njh/modbus-room-sensor/modbus-room-sensor.kicad_pcb

## KiCad design modbus-room-sensor.kicad_pcb (2026-11-06)

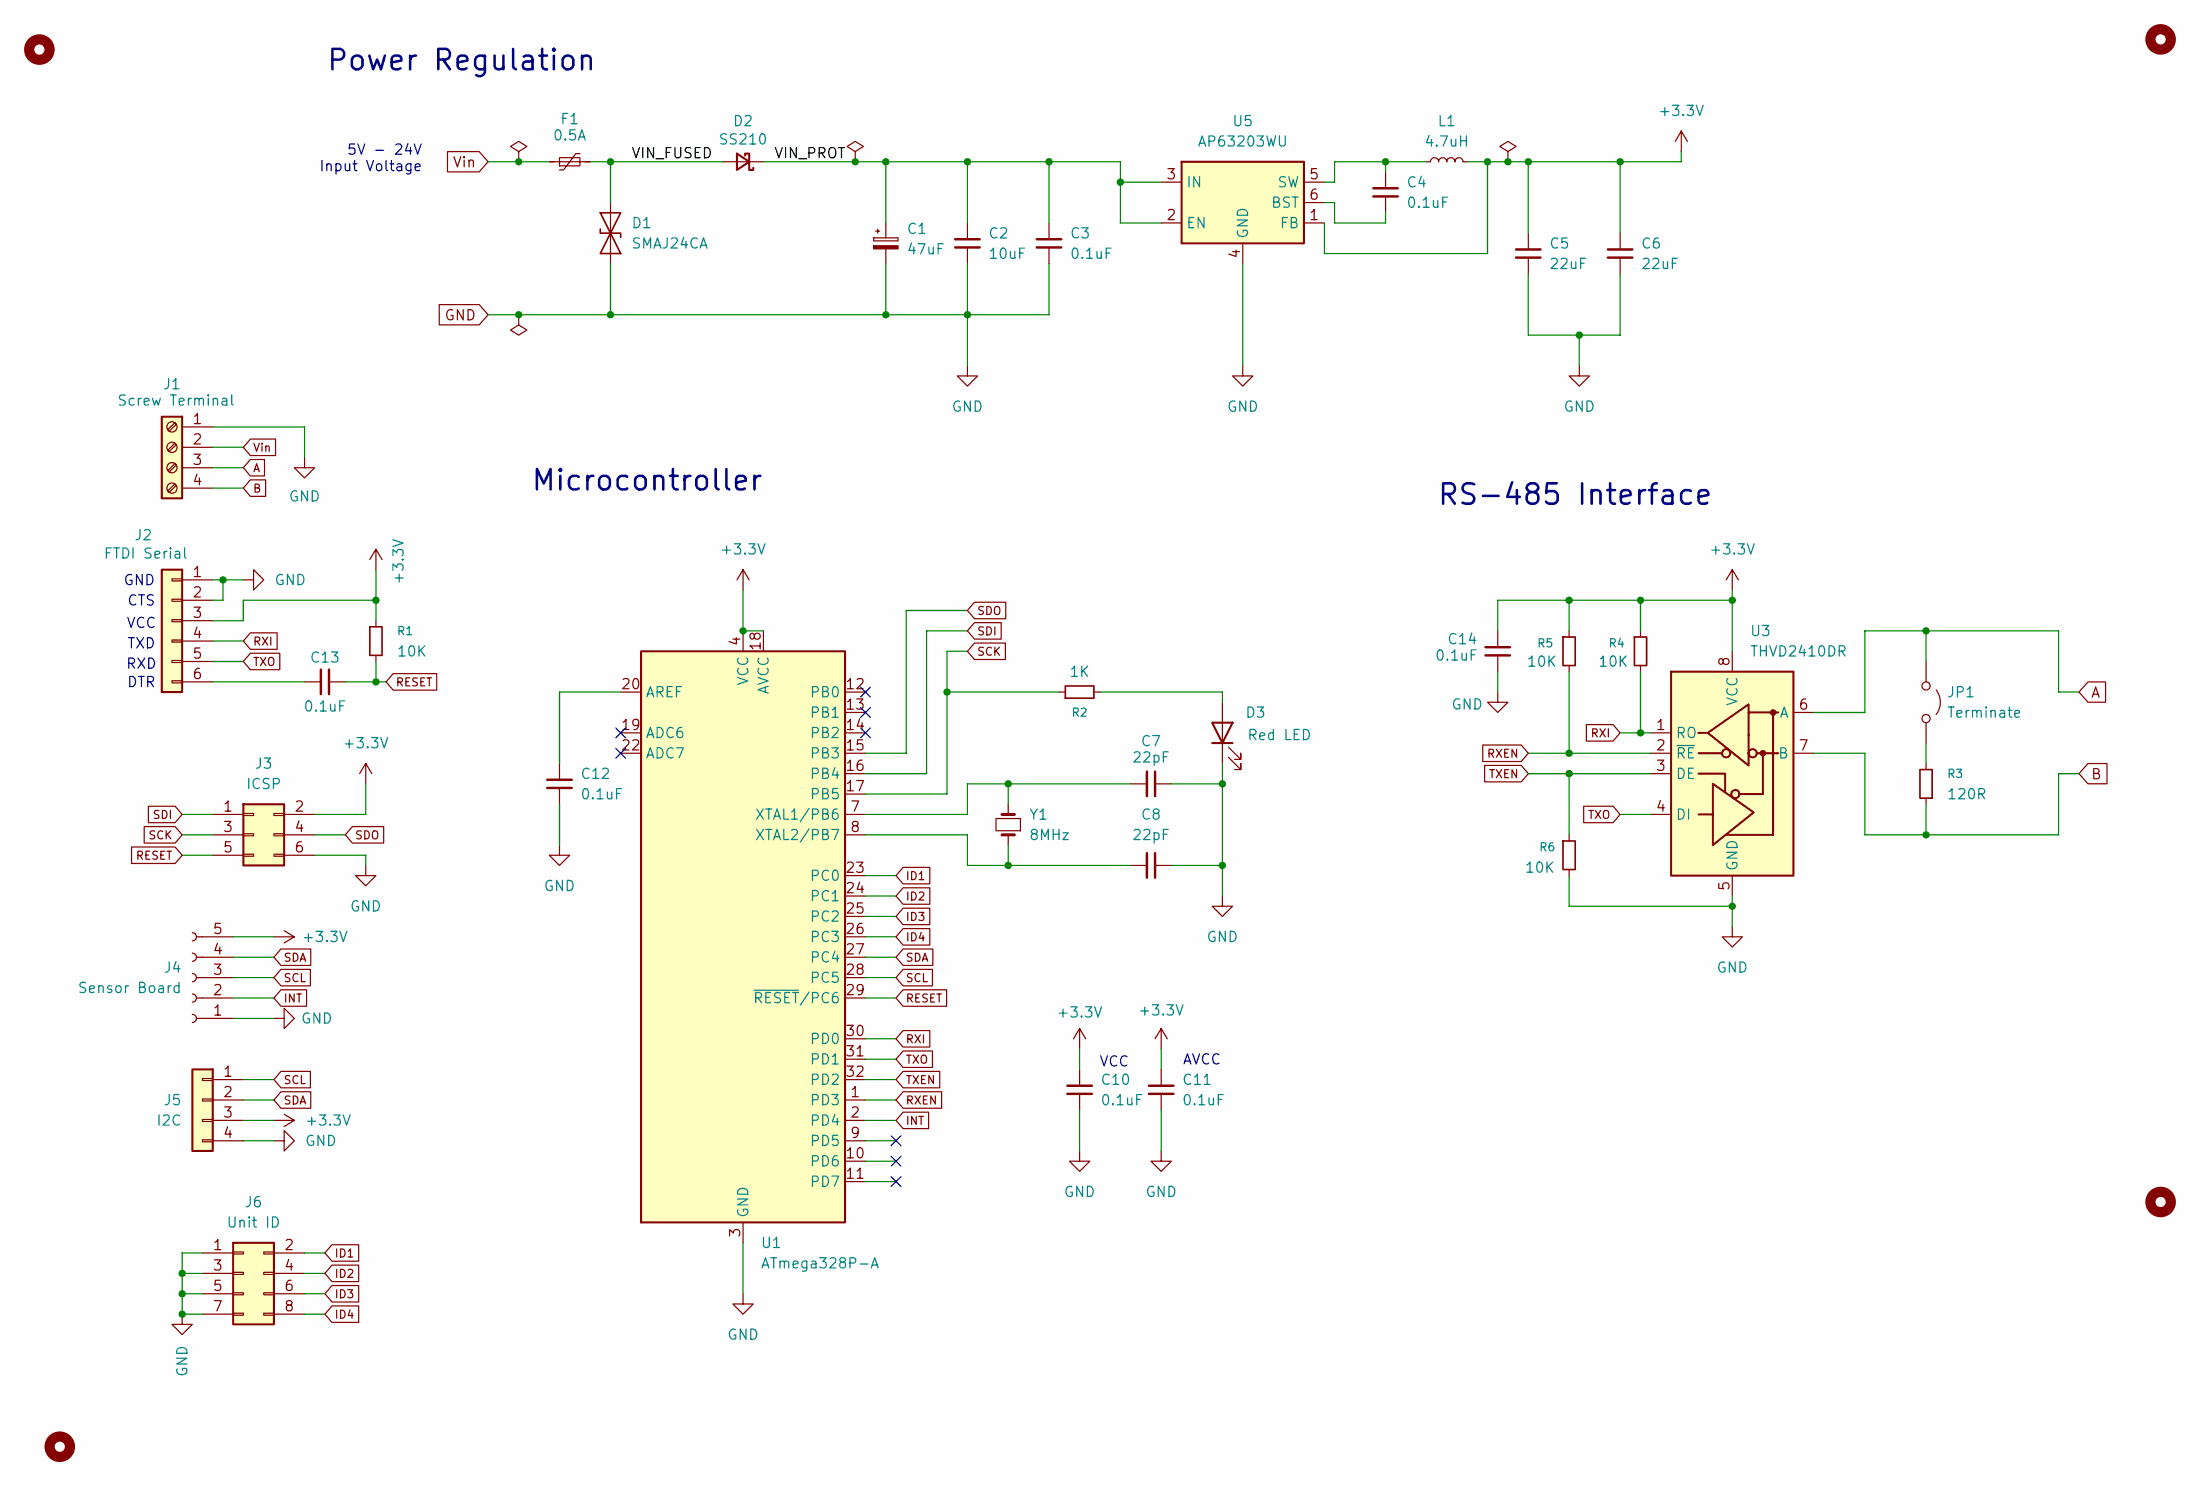
[picture p2: schematic modbus-room-sensor.kicad_sch, Modbus Room Sensor]

Parts:
C1: 47uF; CP_Radial_D6.3mm_P2.50mm
C2: 10uF; C_0805_2012Metric; LCSC C440198
C3, C4: 0.1uF; C_0603_1608Metric; LCSC C14663
C5, C6: 22uF; C_1206_3216Metric; LCSC C12891
C7, C8: 22pF; C_0603_1608Metric; LCSC C1653
C10, C11, C12, C13, C14: 0.1uF; C_0402_1005Metric; LCSC C1525
D1: SMAJ24CA; D_SMA; LCSC C19077542
D2: SS210; D_SMA; LCSC C14996
D3: Red LED; LED_0805_2012Metric; LCSC C84256
F1: 0.5A; C_Disc_D8.0mm_W5.0mm_P5.00mm
H1, H2, H3, H4: MountingHole; MountingHole_2.7mm_M2.5
J1: Screw Terminal; Kefa_HT396R-3.96-04P_1x04_P3.96mm_Horizontal
J2: FTDI Serial; PinHeader_1x06_P2.54mm_Vertical
J3: ICSP; PinHeader_2x03_P2.54mm_Vertical
J4: Sensor Board; PinSocket_1x05_P2.54mm_Horizontal
J5: I2C; JST_PH_B4B-PH-K_1x04_P2.00mm_Vertical
J6: Unit ID; PinHeader_2x04_P2.54mm_Vertical
JP1: Terminate; PinHeader_1x02_P2.54mm_Vertical
L1: 4.7uH; L_Sunlord_SWPA4030S; LCSC C57269
R1, R4, R5, R6: 10K; R_0603_1608Metric; LCSC C25804
R2: 1K; R_0603_1608Metric; LCSC C21190
R3: 120R; R_1206_3216Metric; LCSC C17909
U1: ATmega328P-A; TQFP-32_7x7mm_P0.8mm; LCSC C14877
U3: THVD2410DR; SOIC-8_3.9x4.9mm_P1.27mm; LCSC C1849398
U5: AP63203WU; TSOT-23-6; LCSC C780769
Y1: 8MHz; Crystal_SMD_5032-2Pin_5.0x3.2mm; LCSC C115962

Connections:
+3.3V: C5.1, C6.1, C10.1, C11.1, C14.1, J2.3, J3.2, J4.5, J5.3, L1.2, R1.1, R4.1, R5.1, U1.4 (VCC), U1.6 (VCC), U1.18 (AVCC), U3.8 (VCC), U5.1 (FB)
/VIN_FUSED: D1.2 (A2), D2.2 (A), F1.2
/VIN_PROT: C1.1, C2.1, C3.1, D2.1 (K), U5.2 (EN), U5.3 (IN)
A: J1.3, JP1.1 (A), U3.6 (A)
B: J1.4, R3.1, U3.7 (B)
GND: C1.2, C2.2, C3.2, C5.2, C6.2, C7.2, C8.2, C10.2, C11.2, C12.2, C14.2, D1.1 (A1), D3.1 (K), J1.1, J2.1, J2.2, J3.6, J4.1, J5.4, J6.1, J6.3, J6.5, J6.7, R6.2, U1.3 (GND), U1.5 (GND), U1.21 (GND), U3.5 (GND), U5.4 (GND)
ID1: J6.2, U1.23 (PC0)
ID2: J6.4, U1.24 (PC1)
ID3: J6.6, U1.25 (PC2)
ID4: J6.8, U1.26 (PC3)
INT: J4.2, U1.2 (PD4)
unnamed: D3.2 (A), R2.2
unnamed: C13.1, J2.6
unnamed: JP1.2 (B), R3.2
unnamed: C12.1, U1.20 (AREF)
unnamed: C7.1, U1.7 (XTAL1/PB6), Y1.2
unnamed: C8.1, U1.8 (XTAL2/PB7), Y1.1
unnamed: C4.2, U5.6 (BST)
unnamed: C4.1, L1.1, U5.5 (SW)
RESET: C13.2, J3.5, R1.2, U1.29 (~RESET/PC6)
RXEN: R5.2, U1.1 (PD3), U3.2 (~RE)
RXI: J2.4, R4.2, U1.30 (PD0), U3.1 (RO)
SCK: J3.3, R2.1, U1.17 (PB5)
SCL: J4.3, J5.1, U1.28 (PC5)
SDA: J4.4, J5.2, U1.27 (PC4)
SDI: J3.1, U1.16 (PB4)
SDO: J3.4, U1.15 (PB3)
TXEN: R6.1, U1.32 (PD2), U3.3 (DE)
TXO: J2.5, U1.31 (PD1), U3.4 (DI)
Vin: F1.1, J1.2

Notes on the sheet:
AVCC
TXD
VCC
Microcontroller
5V - 24V Input Voltage
CTS
GND
Power Regulation
DTR
RS-485 Interface
RXD

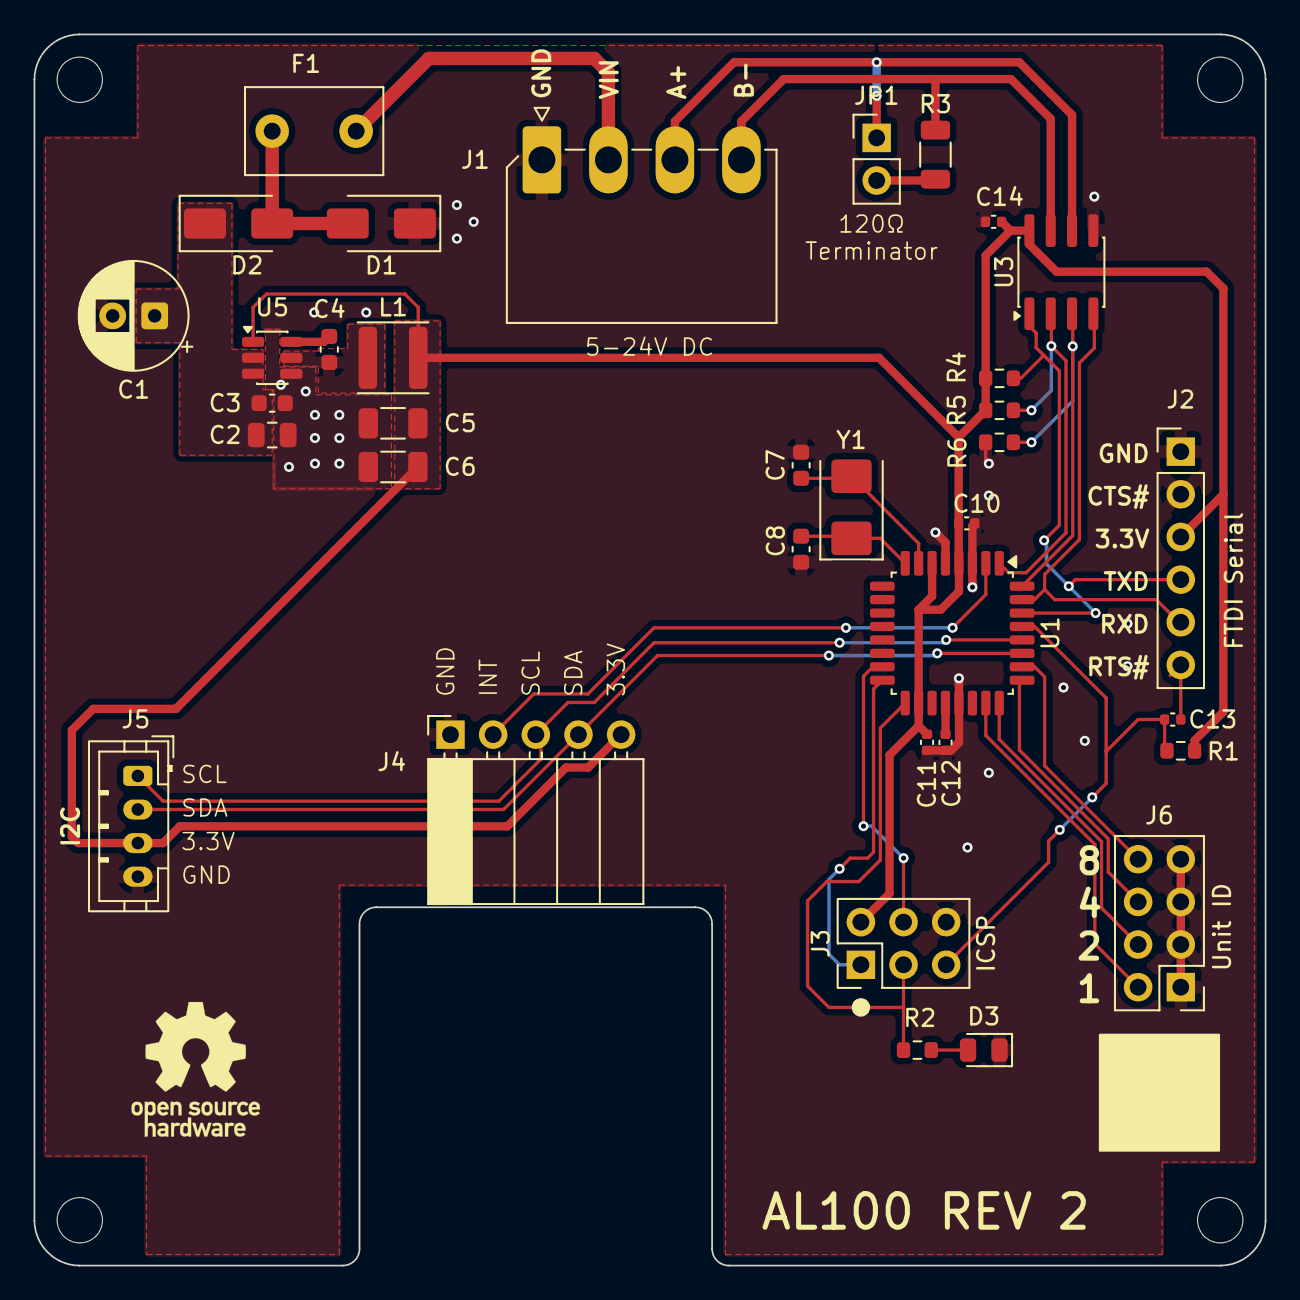
[picture p3: board modbus-room-sensor.kicad_pcb from above]

Board: 2 copper layers, 73.3 x 73.3 mm, 39 parts (0 on the bottom side), 30 nets.
