njh/modbus-room-sensor/sht4x-breakout/sht4x-breakout.kicad_pcb

## KiCad design sht4x-breakout/sht4x-breakout.kicad_pcb (2026-10-26)

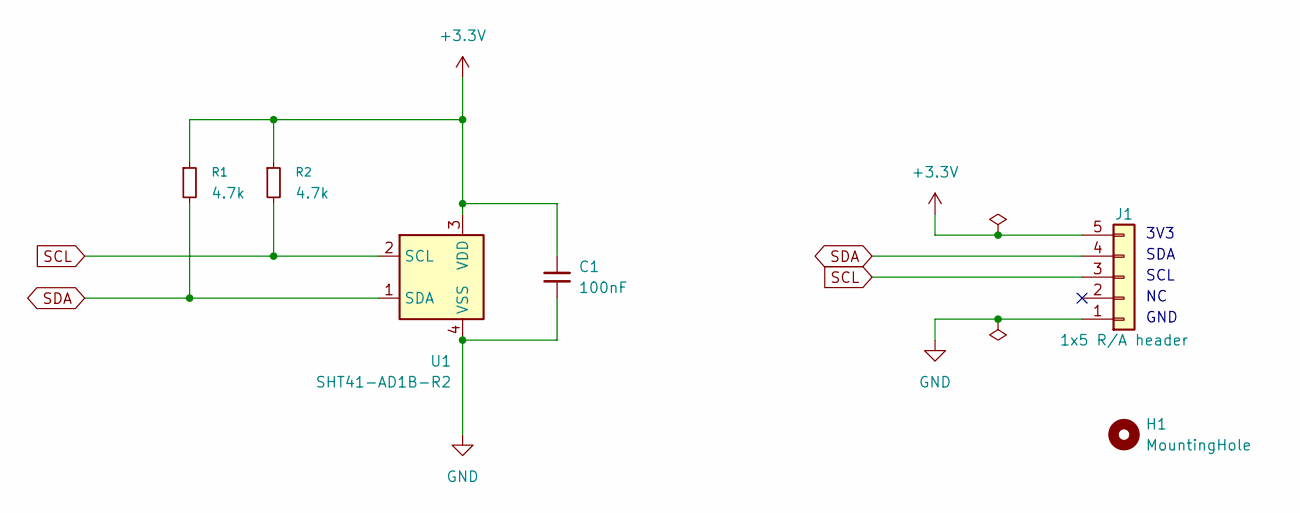
[picture p4: schematic sht4x-breakout.kicad_sch, SHT41 Breakout Module]

Parts:
C1: 100nF; C_0402_1005Metric; LCSC C1525
H1: MountingHole; MountingHole_2.7mm_M2.5
J1: 1x5 R/A header; PinHeader_1x05_P2.54mm_Vertical
R1, R2: 4.7k; R_0603_1608Metric; LCSC C23162
U1: SHT41-AD1B-R2; Sensirion_DFN-4_1.5x1.5mm_P0.8mm_SHT4x_NoCentralPad; LCSC C7461861

Connections:
+3.3V: C1.1, J1.5, R1.1, R2.1, U1.3 (VDD)
GND: C1.2, J1.1, U1.4 (VSS)
SCL: J1.3, R2.2, U1.2 (SCL)
SDA: J1.4, R1.2, U1.1 (SDA)

Notes on the sheet:
SCL
SDA
3V3
GND

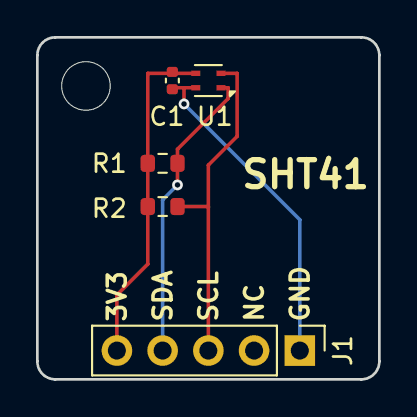
[picture p5: board sht4x-breakout.kicad_pcb from above]

Board: 2 copper layers, 19.0 x 19.0 mm, 6 parts (0 on the bottom side), 4 nets.
