njh/modbus-room-sensor/(commit log)

2025-05-19 Created empty KiCad project
    [modbus-th-sensor.kicad_pcb, modbus-th-sensor.kicad_sch]
2025-06-11 Added Evatron EN30 enclosure datasheet
2025-06-11 Added KiCAD .gitignore
2025-06-11 Schematic is close to being finished now.
    [modbus-th-sensor.kicad_sch]
2025-06-12 MOSI → SDO, MISO → SDI https://oshwa.org/resources/a-resolution-to-redefine-spi-signal-names/
    [modbus-th-sensor.kicad_sch]
2026-02-08 Created PCB for SHT45 sensor on a MikroBus board
    [sht4x-mikrobus.kicad_pcb, sht4x-mikrobus.kicad_sch]
2026-02-20 Switched to AP63203WU buck converter
    [modbus-th-sensor.kicad_sch]
2026-02-20 Make RXEN and TXEND indepentently controllable This is so we can disable RX during Optiboot
    [modbus-th-sensor.kicad_sch]
2026-10-05 Refresh schematic with KiCad 10 - Use custom symbol for the Mikrobus connectors - Removed extra C2 capacitor which wasn't really needed - Jumper was the wrong way round - Added titles to sheet
    [sht4x-mikrobus.kicad_sch]
2026-10-05 Decided to completely redo the PCB added cuts on either sides of the sensor
    [sht4x-mikrobus.kicad_pcb]
2026-10-08 Added KiCAD .history directory to gitignore
2026-10-08 KiCad 10 update: added default board design settings and BOM field list
2026-10-08 Created new breakout board for the SHT41 - decided to go with a much smaller sub-board than the Mikrobus
    [sht4x-breakout.kicad_sch]
2026-10-08 Rework schematic for JLCPCB assembly - Add SM712 TVS diode (D4) to protect the RS-485 A/B lines - Change SP3485CN to SP3485EN - Lower polyfuse rating from 1.0A to 0.75A - Change mounting holes from M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
    [modbus-th-sensor.kicad_sch]
2026-10-08 Updated to KiCad 10
    [modbus-th-sensor.kicad_sch]
2026-10-08 Put components roughly in the right place on PCB
    [modbus-th-sensor.kicad_pcb]
2026-10-09 Updated symbols in KiCad 10. Replaced SHT4x with header for seperate sensor board
    [modbus-th-sensor.kicad_sch]
2026-10-09 Replaced SP3485 with THVD2410, which has built-in protection
    [modbus-th-sensor.kicad_sch]
2026-10-09 Added Qwiic connector
    [modbus-th-sensor.kicad_sch]
2026-10-09 Rework power input for 5-24V and fix part/footprint mismatches - Change TVS D1 from SMAJ18CA to SMAJ24CA (C148223); the SMAJ18CA starts conducting at 20V, below the new 24V maximum input - Replace bu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
    [modbus-th-sensor.kicad_sch]
2026-10-10 Replaced Q1 (AO3401A) with a Schottky Diode (SS210)
    [modbus-th-sensor.kicad_sch]
2026-10-10 Corrected C13 footprint
    [modbus-th-sensor.kicad_sch]
2026-10-10 Reversed FTDI connector so it is the right way round
    [modbus-th-sensor.kicad_sch]
2026-10-10 Switched SMAJ24CA to a JLC basic part
    [modbus-th-sensor.kicad_sch]
2026-10-10 Changed C1 to be a 47uF through-hole
    [modbus-th-sensor.kicad_sch]
2026-10-10 Switched some components to Through Hole for hand soldering. Removed components the from pick and place.
    [modbus-th-sensor.kicad_sch]
2026-10-10 Changed capacitor C5/C6 part number and footprint
    [modbus-th-sensor.kicad_sch]
2026-10-10 Switched to JST PH 2.0mm 4-pin connector footprint for I2C socket I don't plan to populate it - but it is available as a backup. This footprint should be compatible with Adafruit STEMMA and Grove
    [modbus-th-sensor.kicad_sch]
2026-10-10 Added breakout PCB design
    [sht4x-breakout.kicad_pcb, sht4x-breakout.kicad_sch]
2026-10-10 Added (mirror x) to the sensor board header
    [modbus-th-sensor.kicad_sch]
2026-10-11 Added pull-up resistors to RS-485 interface
    [modbus-th-sensor.kicad_sch]
2026-10-11 Added Kefa HT396 footprints
    [modbus-th-sensor.kicad_sch]
2026-10-11 Moved all connectors to the left of the schematic
    [modbus-th-sensor.kicad_sch]
2026-10-11 Finished routing main board
    [modbus-th-sensor.kicad_pcb, modbus-th-sensor.kicad_sch]
2026-10-11 Main board tidy ups - Move U5 FB track away from SW node, BST pad and L1 - Add extra GND vias - Move R1 (RESET pull-up) next to U1 - Include J5 in the BOM, consistent with other hand-fitted connectors
    [modbus-th-sensor.kicad_pcb, modbus-th-sensor.kicad_sch]
2026-10-11 Moved crystal closer to the microcontroller
    [modbus-th-sensor.kicad_pcb]
2026-10-12 Mikrobus is no-longer part of this project. It remains in a branch here: https://github.com/njh/modbus-th-sensor/tree/mikrobus
    [sht4x-mikrobus.kicad_pcb, sht4x-mikrobus.kicad_sch]
2026-10-18 Breakout board revision 2: square outline and mounting hole - Changed the outline to a plain 19 x 19 mm square, removing the narrow header end - Added an M2.5 mounting hole (H1) at X 2.7, Y 2.7 to th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
    [sht4x-breakout.kicad_pcb, sht4x-breakout.kicad_sch]
2026-10-20 Re-worked main board for the Camdenboss CBRS01 series of enclosures - New 73.32 x 73.32 mm outline, with M2.5 mounting holes - Moved the sensor notch so the breakout's mounting hole sits on the lid's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
    [modbus-th-sensor.kicad_pcb, modbus-th-sensor.kicad_sch]
2026-10-21 Minor adjustments and label changes
    [sht4x-breakout.kicad_pcb, sht4x-breakout.kicad_sch]
2026-10-21 Moved buck converter FB back to the front layer Minor value and label changes.
    [modbus-th-sensor.kicad_pcb, modbus-th-sensor.kicad_sch]
2026-10-21 Silkscreen adjustments, added OSHW logos
    [modbus-th-sensor.kicad_pcb, sht4x-breakout.kicad_pcb]
2026-10-22 Renamed project from modbus-th-sensor to modbus-room-sensor
    [modbus-room-sensor.kicad_pcb, modbus-room-sensor.kicad_sch]
2026-10-26 Added Makefile to generate schematics
2026-10-26 Updated breakout board header footprint Changed track size down to 0.2mm Bumped revision to 3
    [sht4x-breakout.kicad_pcb]
2026-10-27 Added generating gerbers to Makefile
2026-11-02 Removed datasheet for EN30 - decided not to use it. It has strange mounting post positions and doesn't cover a UK 1 gang backbox
2026-11-06 Removed left over labels on the comments layer
    [modbus-room-sensor.kicad_pcb]
2026-11-06 Changed bootloader to flash LED 3 times
2026-11-06 Run build as the kicad user
2026-11-06 Added Photo of AL100 Rev 2 in enclosure
2026-11-07 Added firmware Arduino Sketch
2026-11-09 Added publishing of schematic PDFs to Github Pages
