njh/modbus-room-sensor/(notices)

Notices in the files:
README.md:
License: MIT
